floesche/LED-Display_G3_Hardware_Controller_BNC/README.md

---
title: BNC Breakout
parent: Generation 3
---

## Project content

```
├── gerber_v1.0
├── gerber_v1.1
│   └── old
├── lib
└── mod
```
