floesche/LED-Display_G3_Hardware_Controller_BNC/production_v1/BOM.txt

Part        Description                      Vendors   
-----------------------------------------------------------------------------
P1,P2       5x2 male shrouded header         jameco 67812,  Digi-Key S9169-ND
P3          4-pin friction lock header       jameco 613958, Digi-Key A1922-ND
P4-P13      socket BNC connector                            Digi-Key A97555-ND 
P14         13x2 male shrouded header        jameco 68372,  Digi-Key S9173-ND
