floesche/LED-Display_G3_Hardware_Controller_BNC/docs/assets/panels_bnc_breakout.pdf

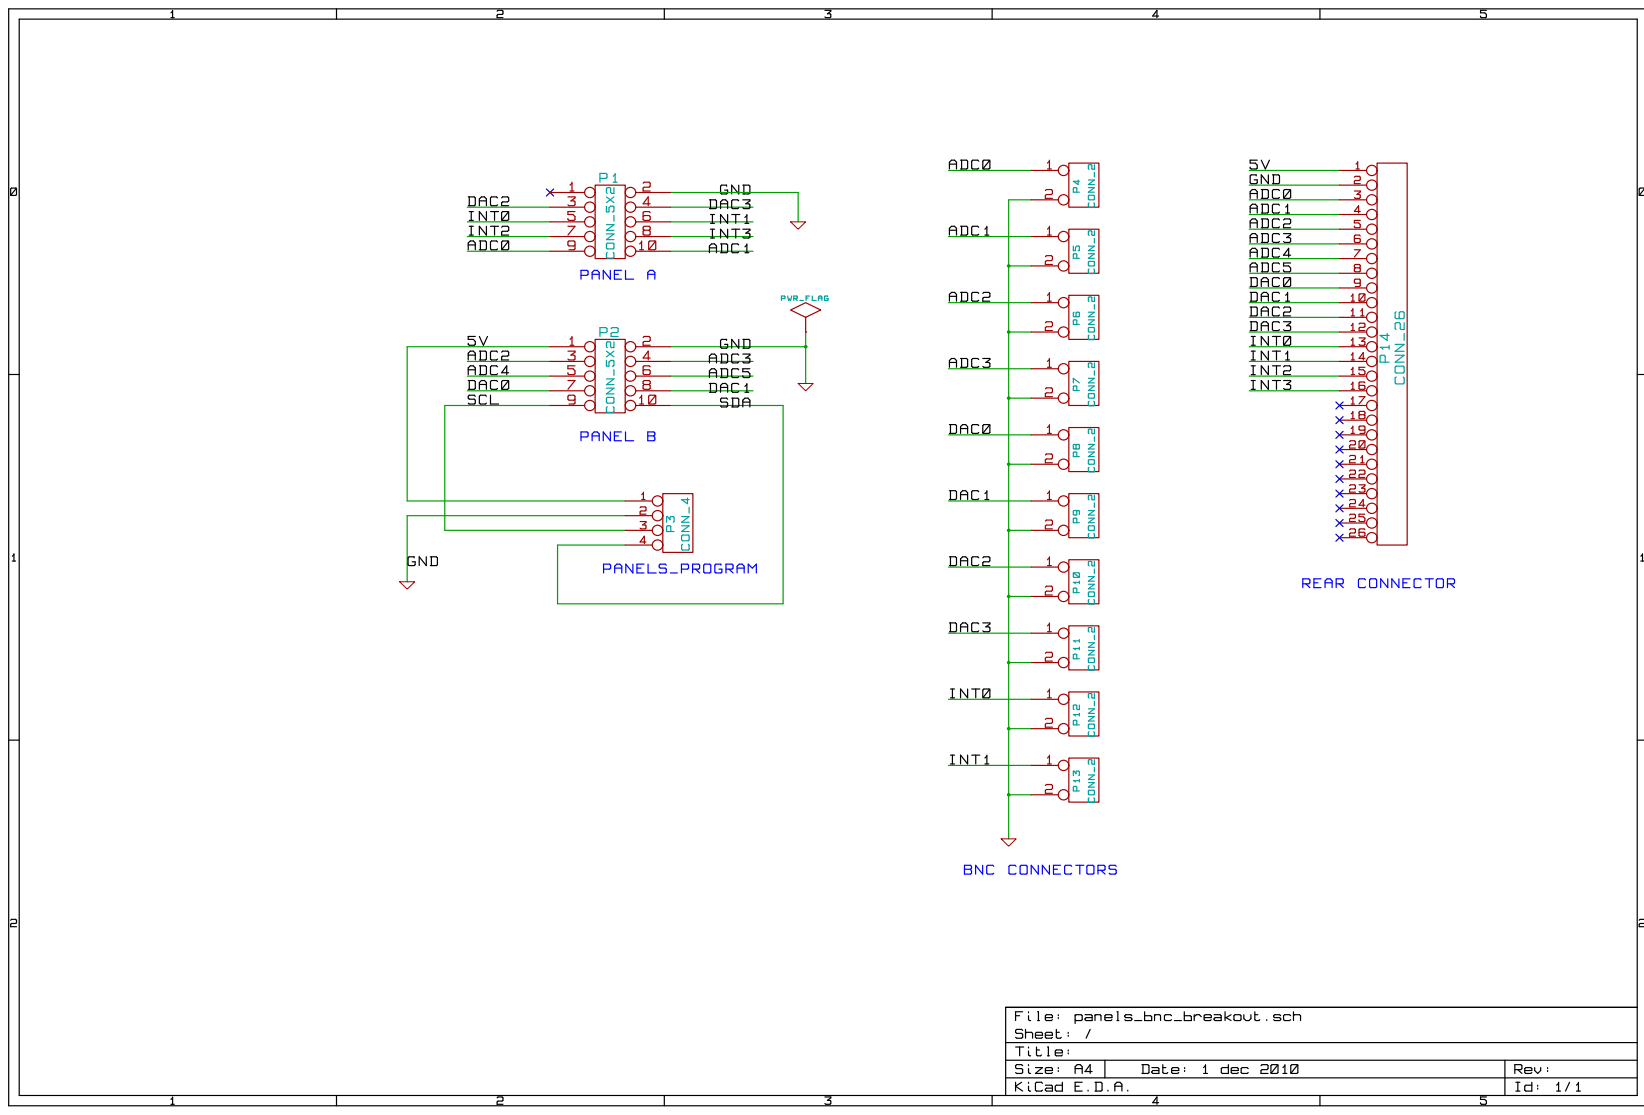
[picture p4: page 1]
