floesche/LED-Display_G3_Hardware_Controller_BNC/panels_bnc_breakout.kicad_pcb

## KiCad design panels_bnc_breakout.kicad_pcb (2015-08-14)

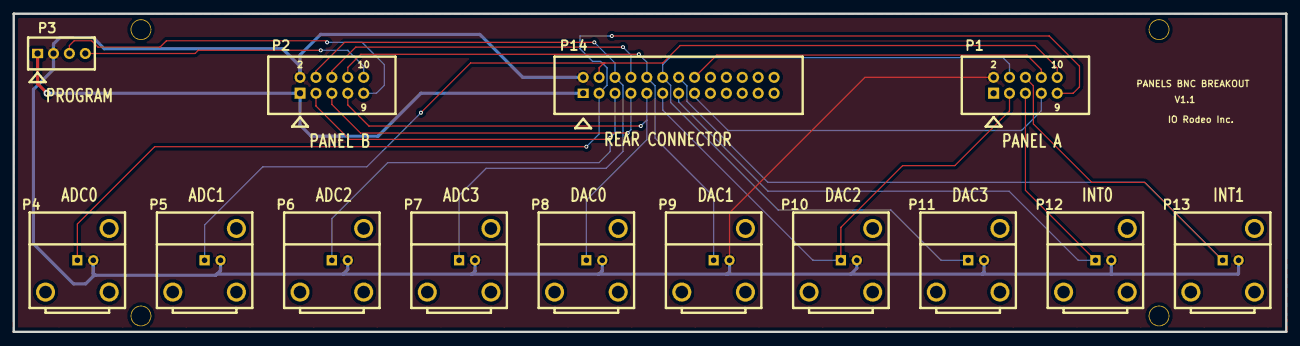
[picture p5: board panels_bnc_breakout.kicad_pcb from above]

Board: 2 copper layers, 203.2 x 50.8 mm, 18 parts (0 on the bottom side), 18 nets.

Parts:
MOUNT_HOLE: VAL**; MOUNT_HOLE
MOUNT_HOLE#2, MOUNT_HOLE#3, MOUNT_HOLE#4: VAL**; MOUNT_HOLE
P1, P2: CONN_5X2; HEADER_5x2_LARGE
P3: CONN_4; conn_sh_4x1
P4, P5, P6, P7, P8, P9, P10, P11, P12, P13: CONN_2; BNC
P14: CONN_26; conn_sh_26x2

Connections:
/5V: P2.1, P3.1, P14.1
/ADC0: P1.9, P4.1, P14.3
/ADC1: P1.10, P5.1, P14.4
/ADC2: P2.3, P6.1, P14.5
/ADC3: P2.4, P7.1, P14.6
/ADC4: P2.5, P14.7
/ADC5: P2.6, P14.8
/DAC0: P2.7, P8.1, P14.9
/DAC1: P2.8, P9.1, P14.10
/DAC2: P1.3, P10.1, P14.11
/DAC3: P1.4, P11.1, P14.12
/GND: P1.2, P2.2, P3.2, P4.2, P5.2, P6.2, P7.2, P8.2, P9.2, P10.2, P11.2, P12.2, P13.2, P14.2
/INT0: P1.5, P12.1, P14.13
/INT1: P1.6, P13.1, P14.14
/INT2: P1.7, P14.15
/INT3: P1.8, P14.16
/SCL: P2.9, P3.3
/SDA: P2.10, P3.4
