floesche/LED-Display_G3_Hardware_Controller_BNC/(commit log)

2010-12-08 Project creation.
    [$savepcb.brd, panels_bnc_breakout.brd, panels_bnc_breakout.sch]
2010-12-23 Added gerber files for version 1.0 and BOM.
    [$savepcb.brd, panels_bnc_breakout.brd, panels_bnc_breakout.sch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]
2011-01-24 Fixed bug in pcb schematic DAC1 and DAC3 where swapped similarly, DAC2 and DAC0 where swapped. Created new ps and pdf versions of the schmatic. Created new set of gerber and drill fills. Version numb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
    [$savepcb.brd, panels_bnc_breakout.brd, panels_bnc_breakout.sch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]
2011-02-03 Re-made v1.1 gerber files.
    [panels_bnc_breakout.brd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]
2011-09-09 Added rear connector pinout.
2015-08-14 Added new version of gerber files + .zip archive for ordering.
    [panels_bnc_breakout-B_Mask.gbs, panels_bnc_breakout-B_SilkS.gbo, panels_bnc_breakout-Component.gtl, panels_bnc_breakout-Copper.gbl, panels_bnc_breakout-Edge_Cuts.gbr, panels_bnc_breakout-F_Mask.gts, panels_bnc_breakout-F_SilkS.gto, panels_bnc_breakout.drl]
2015-08-14 Added drill file.
    [panels_bnc_breakout.drl]
2015-08-14 Fixed issue with zones.
    [panels_bnc_breakout.kicad_pcb]
2021-11-12 cleanup bnc
    [$savepcb.brd, panels_bnc_breakout.brd]
2021-11-12 repair schema
    [panels_bnc_breakout.sch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]
2021-11-12 update production files
    [panels_bnc_breakout-B_Mask.gbs, panels_bnc_breakout-B_SilkS.gbo, panels_bnc_breakout-Component.gtl, panels_bnc_breakout-Copper.gbl, panels_bnc_breakout-Edge_Cuts.gbr, panels_bnc_breakout-F_Mask.gts, panels_bnc_breakout-F_SilkS.gto, panels_bnc_breakout.drl]
2021-11-12 improve documentation
    [panels_bnc_breakout.sch]
